Frzoen/index/pnp/cad/stl_rev_1.0.0/xCarriageSpacer.stl

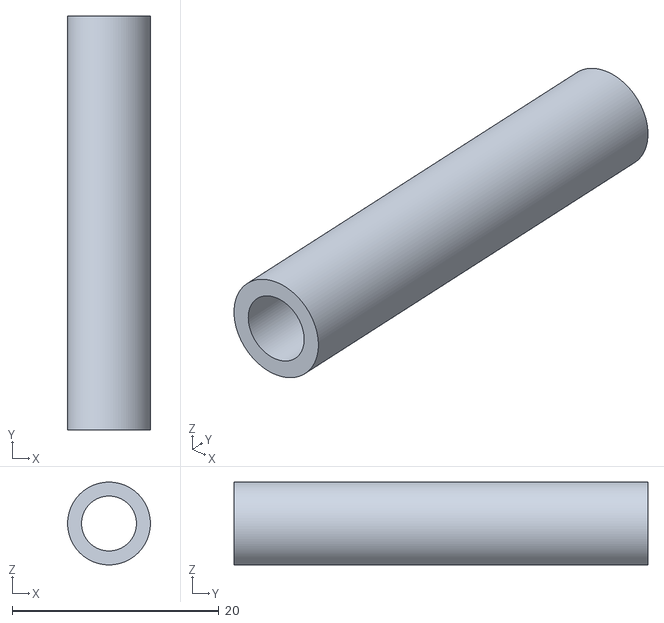
[picture p4: CAD file, 2020-05-16]
pnp/cad/stl_rev_1.0.0/xCarriageSpacer.stl
8.00 x 40.0 x 8.00
