Frzoen/index/pnp/cad/stl_rev_1.0.0/xCarriageBack.stl

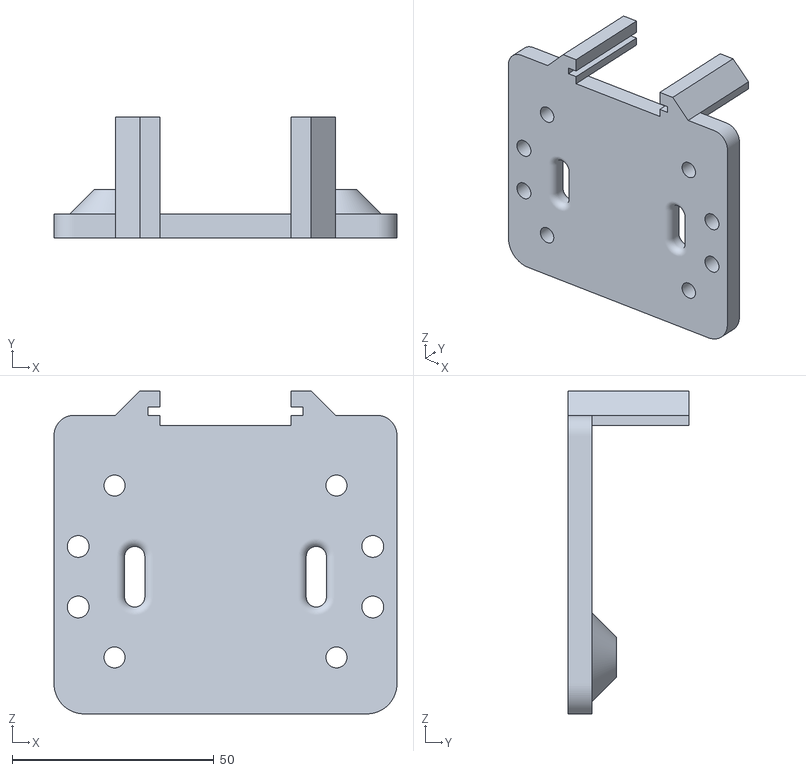
[picture p5: CAD file, 2020-05-16]
pnp/cad/stl_rev_1.0.0/xCarriageBack.stl
85.0 x 30.0 x 80.0
